carlallen/fermenticle/board/fermenticle.kicad_pcb

## KiCad design board/fermenticle.kicad_pcb (2016-04-24)

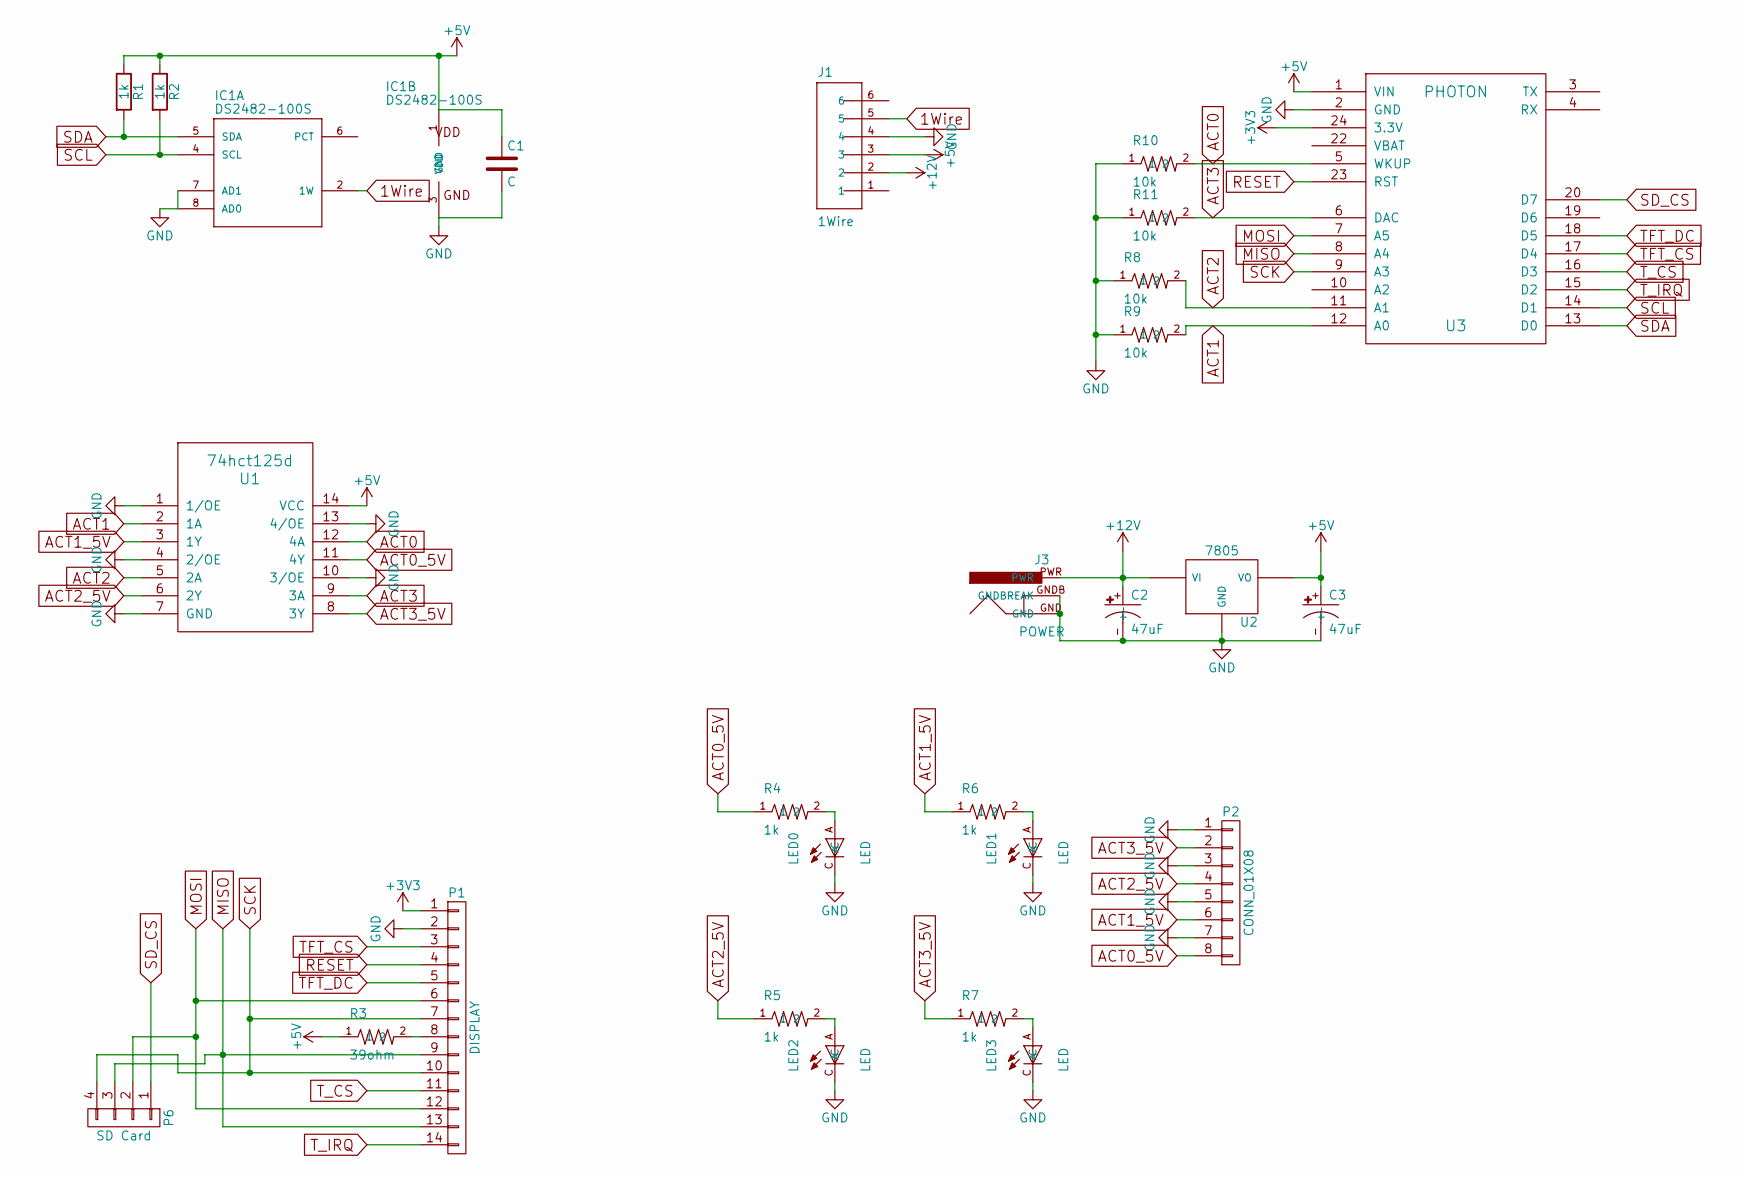
[picture p1: schematic fermenticle.sch]

Parts:
C1: C; C_0805_HandSoldering
C2, C3: 47uF; SparkFun-PANASONIC_D
IC1: DS2482-100S; 1wire-SO08
J1: 1Wire; SparkFun-RJ11-6
J3: POWER; SparkFun-POWER_JACK_PTH
LED0, LED1, LED2, LED3: LED; SparkFun-LED-0603
P1: DISPLAY; Socket_Strip_Straight_1x14
P2: CONN_01X08; mstba_2,5%2f8-g-5,08
P6: SD Card; Pin_Header_Angled_1x04
R1, R2, R4, R5, R6, R7: 1k; R_0805_HandSoldering
R3: 39ohm; R_0805_HandSoldering
R8, R9, R10, R11: 10k; R_0805_HandSoldering
U1: 74hct125d; SparkFun-SOIC-14
U2: 7805; SparkFun-V-REG_DPACK
U3: PHOTON

Connections:
1Wire: IC1.2 (1W), J1.5
+3V3: P1.1, U3.24 (3.3V)
+5V: C1.1, C3.+, IC1.1 (VDD), J1.3, R1.1, R2.1, R3.1, U1.14 (VCC), U2.3 (VO), U3.1 (VIN)
+12V: C2.+, J1.2, J3.PWR, U2.1 (VI)
ACT0: R10.2, U1.12 (4A), U3.5 (WKUP)
ACT0_5V: P2.8, R4.1, U1.11 (4Y)
ACT1: R9.2, U1.2 (1A), U3.12 (A0)
ACT1_5V: P2.6, R6.1, U1.3 (1Y)
ACT2: R8.2, U1.5 (2A), U3.11 (A1)
ACT2_5V: P2.4, R5.1, U1.6 (2Y)
ACT3: R11.2, U1.9 (3A), U3.6 (DAC)
ACT3_5V: P2.2, R7.1, U1.8 (3Y)
GND: C1.2, C2.-, C3.-, IC1.3 (GND), IC1.7 (AD1), IC1.8 (AD0), J1.4, J3.GND, J3.GNDB (GNDBREAK), LED0.C, LED1.C, LED2.C, LED3.C, P1.2, P2.1, P2.3, P2.5, P2.7, R8.1, R9.1, R10.1, R11.1, U1.1 (1/OE), U1.4 (2/OE), U1.7 (GND), U1.10 (3/OE), U1.13 (4/OE), U2.4 (GND), U3.2 (GND)
MISO: P1.9, P1.13, P6.3, U3.8 (A4)
MOSI: P1.6, P1.12, P6.2, U3.7 (A5)
unnamed: LED0.A, R4.2
unnamed: LED1.A, R6.2
unnamed: LED2.A, R5.2
unnamed: LED3.A, R7.2
unnamed: P1.8, R3.2
RESET: P1.4, U3.23 (RST)
SCK: P1.7, P1.10, P6.4, U3.9 (A3)
SCL: IC1.4 (SCL), R2.2, U3.14 (D1)
SDA: IC1.5 (SDA), R1.2, U3.13 (D0)
SD_CS: P6.1, U3.20 (D7)
TFT_CS: P1.3, U3.17 (D4)
TFT_DC: P1.5, U3.18 (D5)
T_CS: P1.11, U3.16 (D3)
T_IRQ: P1.14, U3.15 (D2)

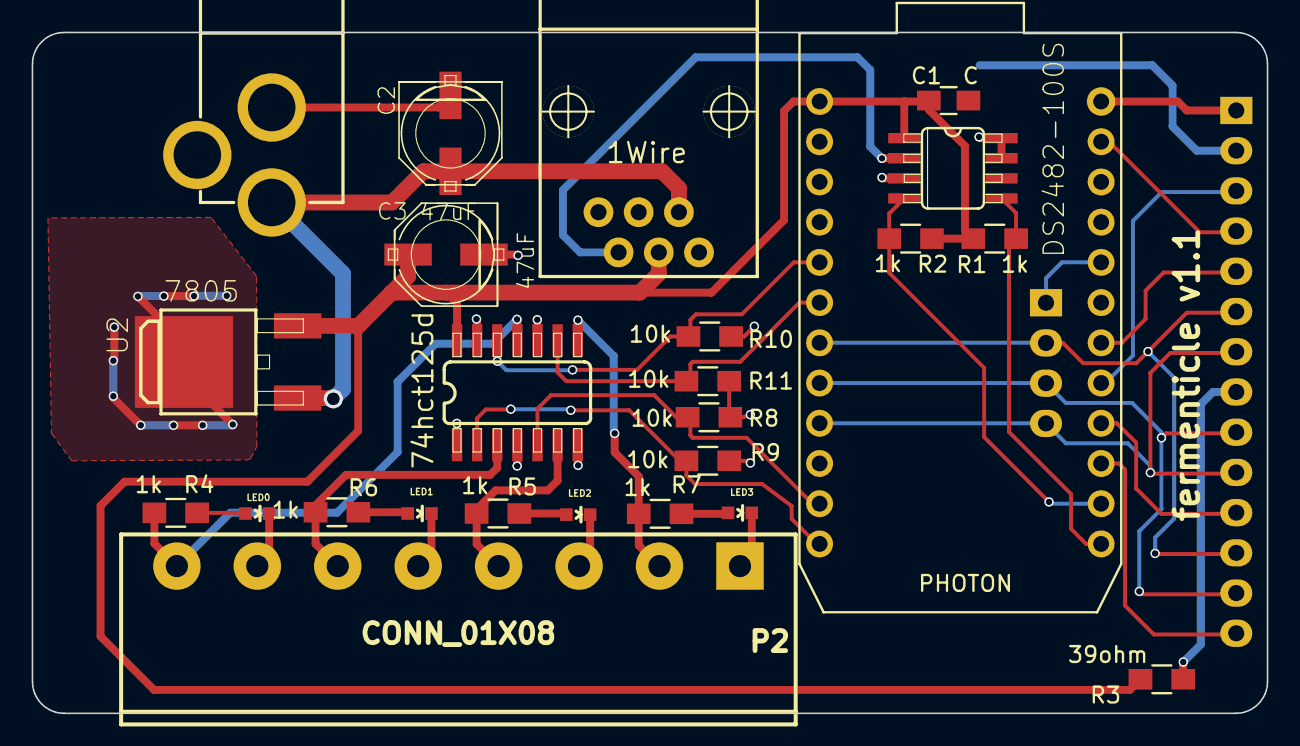
[picture p2: board fermenticle.kicad_pcb from above]

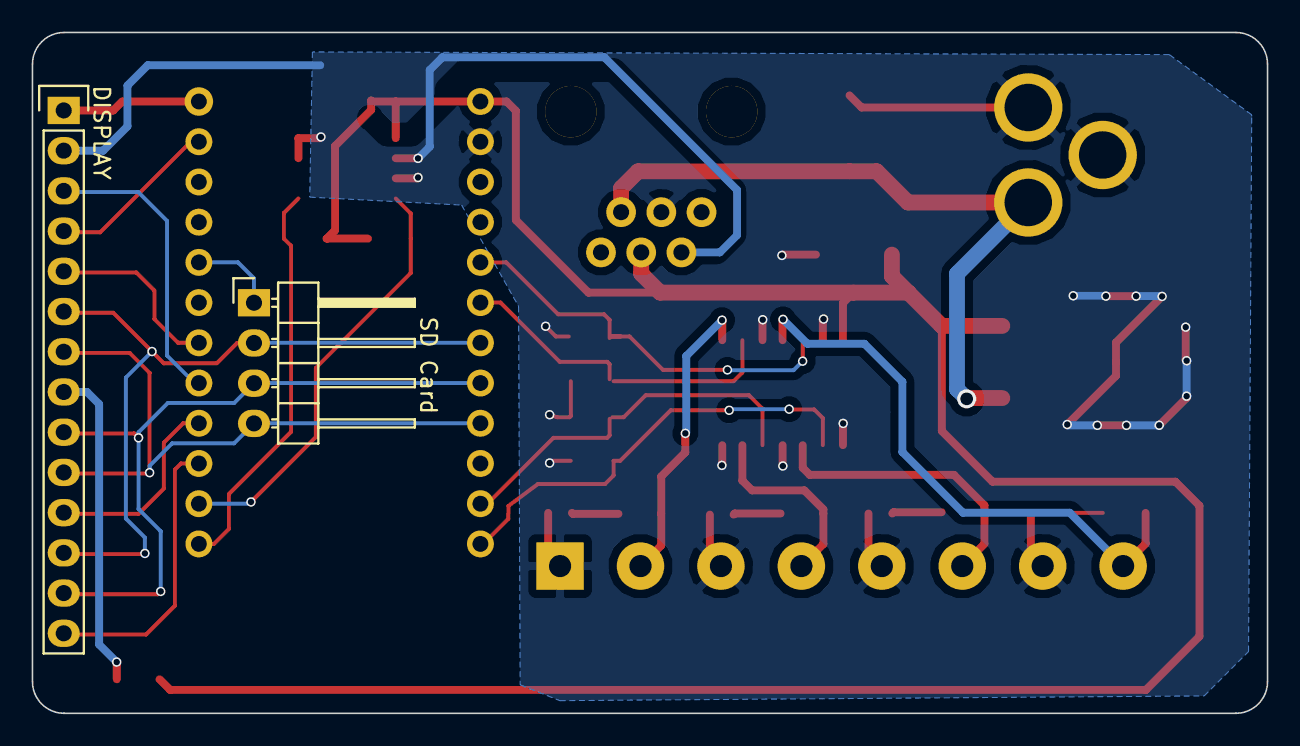
[picture p3: board fermenticle.kicad_pcb from below]

Board: 2 copper layers, 78.0 x 43.0 mm, 27 parts (2 on the bottom side), 29 nets.
