carlallen/fermenticle/app/TempSensorManager.cpp

#include "TempSensorManager.h"
#include "GlobalOneWire.h"

TempSensorManager::TempSensorManager() : beerSensor(), fridgeSensor() { }

void TempSensorManager::init() {
  dallas->requestTemperatures();
}

void TempSensorManager::updateSensors() {
  beerSensor.update();
  fridgeSensor.update();
}

RawTemperature TempSensorManager::fridgeTemp() {
  return fridgeSensor.temp();
}

RawTemperature TempSensorManager::beerTemp() {
  return beerSensor.temp();
}

bool TempSensorManager::beerSensorConnected() {
  return beerSensor.connected();
}

bool TempSensorManager::fridgeSensorConnected() {
  return fridgeSensor.connected();
}

bool TempSensorManager::ready() {
  return fridgeSensorConnected() && beerSensorConnected();
}

TempSensorManager tempSensorMgr;
