carlallen/fermenticle/(commit log)

2016-04-19 Default first sensor for demo development
    [fermenticle.kicad_pcb, fermenticle.sch]
2016-04-24 Better layout for v1.1
    [fermenticle.kicad_pcb, fermenticle.sch]
2016-04-24 Ability to set Output devices
2016-04-25 allow setting all base devices
2016-05-10 Setpoint adjust buttons
2016-05-12 Temperature Control
